ironiron/LCRmeter/LCRmeter_PCB/readme.md

# todo

- add connector for UART converter for debugging
- add testpoint for ADC measurments
- make oled from discrete parts, not module
- change connector for programmmer, and move it out of the top layer
- check if PCB can be smaller (especially batterry holder)
- add more Rseries options
- remove option without Rseries connected at all - it can fry PCB
- remove connection to 2nd ADCs
- Are there  better opamps??
- remove option for 1.5 V ref
