ironiron/LCRmeter/visualizer_data/r2k2ohm.png

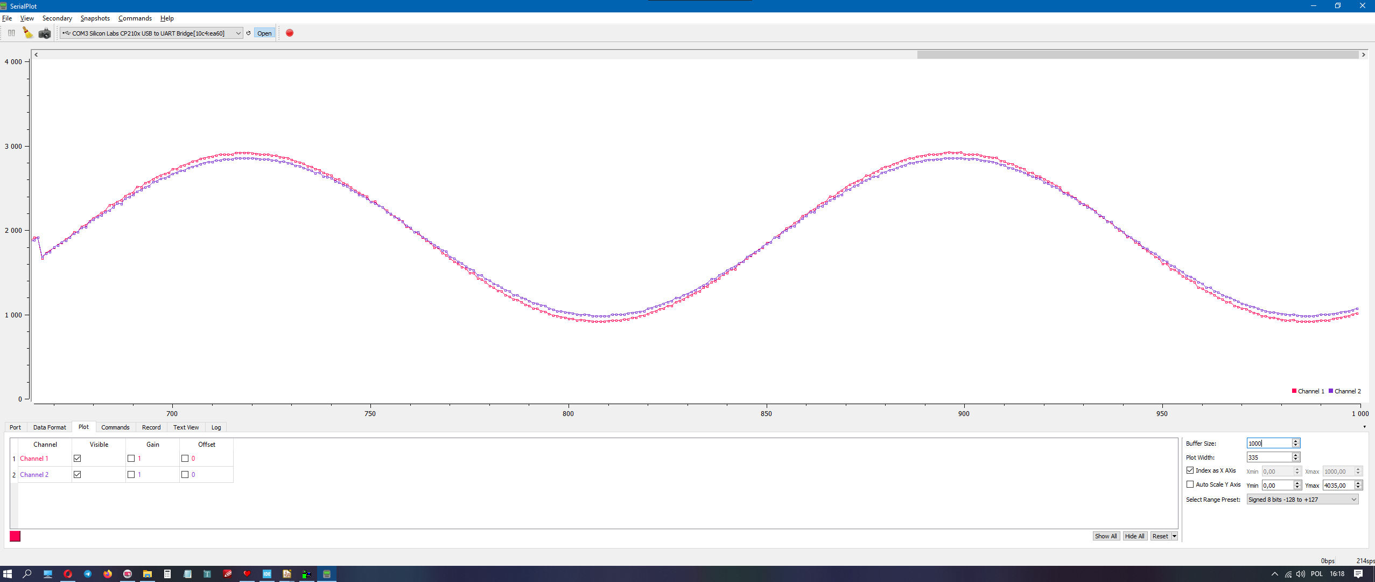
visualizer_data/r2k2ohm.png
