ironiron/LCRmeter/tests/readme.md

period of ADC data auqisition is 2.5us and is visivle on oscilloscope on waveform (photo quickprint 1)
qiuckprint 2 is merelry visible impact when coil is connected. quickprint 3 is fo electrolic capabilties
quickprint 4 is the fastest that I've managed on coil

# Power consumption
Module takes ca. 45 mA when DAC, adc is running
