ironiron/LCRmeter/tests/ADC sampling - 1.png

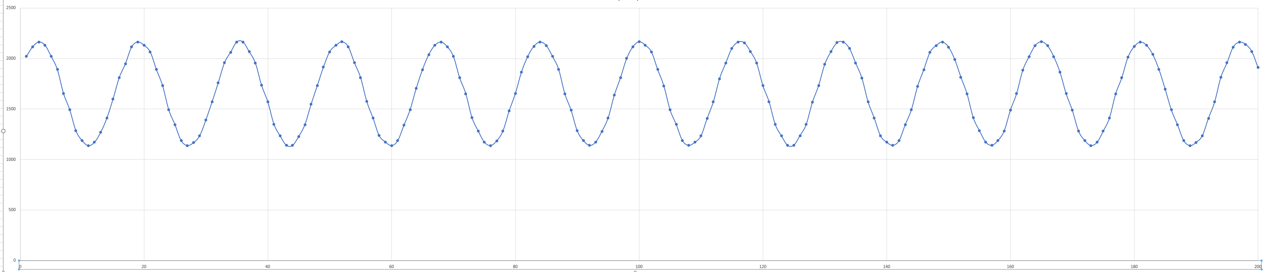
tests/ADC sampling - 1.png
