ironiron/LCRmeter/LCRmeter_PCB/lcrmeter.kicad_pcb

## KiCad design LCRmeter_PCB/lcrmeter.kicad_pcb (2024-01-05)

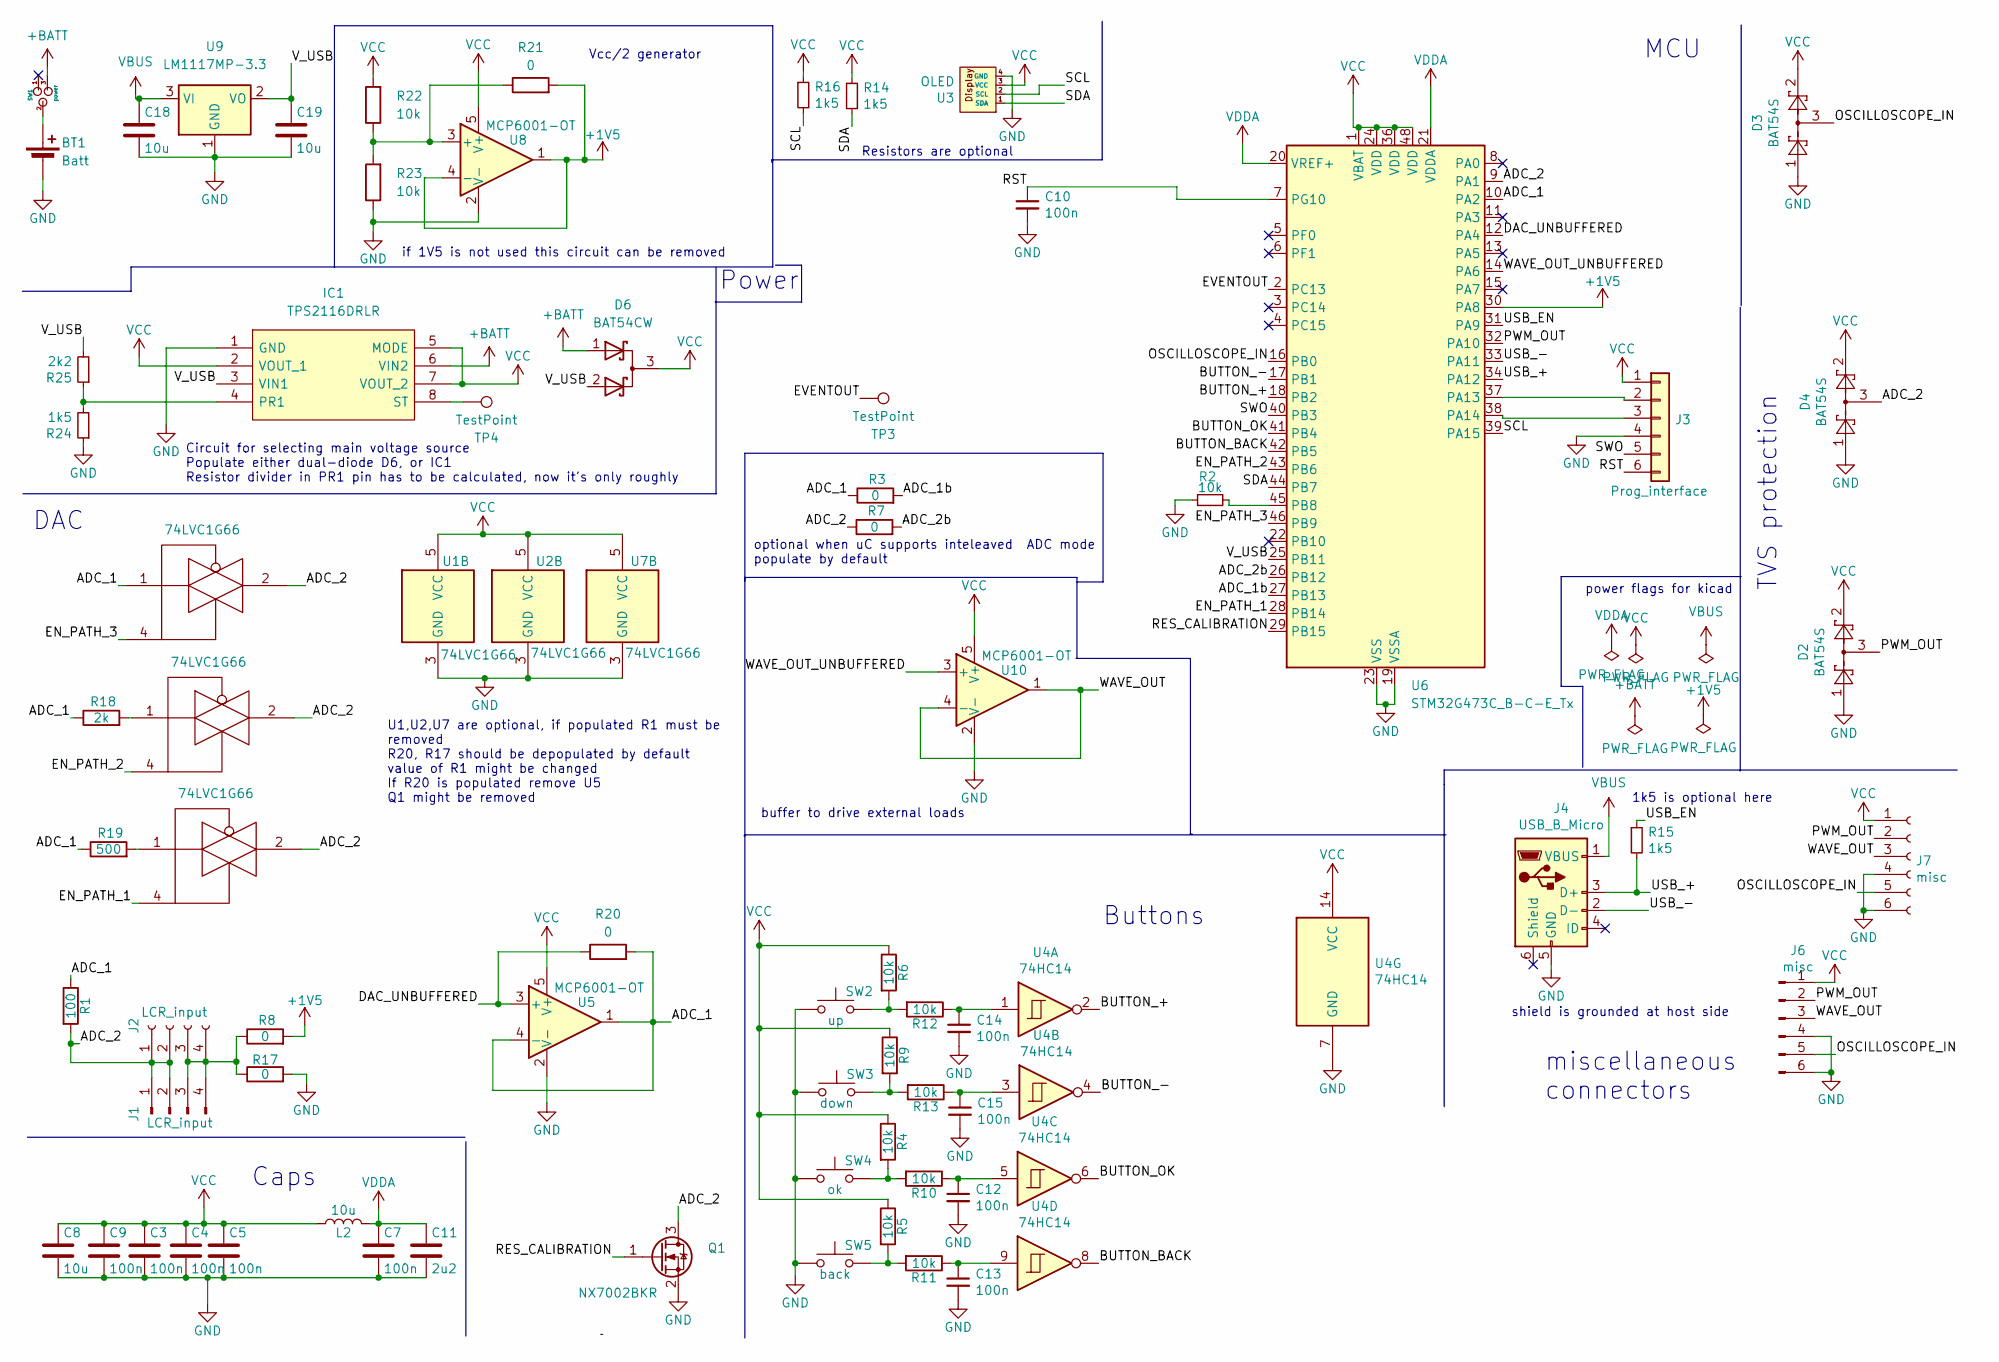
[picture p11: schematic lcrmeter.kicad_sch]

Parts:
BT1: Batt; BatteryHolder_Keystone_2468_2xAAA
C3, C4, C5, C7, C9, C10, C12, C13, C14, C15: 100n; C_0603_1608Metric_Pad1.08x0.95mm_HandSolder
C8, C18, C19: 10u; C_0805_2012Metric_Pad1.18x1.45mm_HandSolder
C11: 2u2; C_0603_1608Metric_Pad1.08x0.95mm_HandSolder
D2, D3, D4: BAT54S; SOT-23
D6: BAT54CW; SOT-23
IC1: TPS2116DRLR; SOTFL50P160X60-8N; Mouser Part Number 595-TPS2116DRLR
J1: LCR_input; PinHeader_1x04_P2.54mm_Vertical
J2: LCR_input; PinSocket_1x04_P2.54mm_Vertical
J3: Prog_interface; PinHeader_1x06_P2.54mm_Vertical
J4: USB_B_Micro; USB_Micro-B_Molex_47346-0001
J6: misc; PinSocket_1x06_P2.54mm_Vertical
J7: misc; PinHeader_1x06_P2.54mm_Vertical
L2: 10u; L_0805_2012Metric_Pad1.15x1.40mm_HandSolder
Q1: NX7002BKR; SOT-23
R1: 100; R_0805_2012Metric_Pad1.20x1.40mm_HandSolder
R2, R4, R5, R6, R9, R10, R11, R12, R13: 10k; R_0603_1608Metric_Pad0.98x0.95mm_HandSolder
R3, R7, R8, R17, R20, R21: 0; R_0805_2012Metric_Pad1.20x1.40mm_HandSolder
R14, R15, R16, R24: 1k5; R_0805_2012Metric_Pad1.20x1.40mm_HandSolder
R18: 2k; R_0805_2012Metric_Pad1.20x1.40mm_HandSolder
R19: 500; R_0805_2012Metric_Pad1.20x1.40mm_HandSolder
R22, R23: 10k; R_0805_2012Metric_Pad1.20x1.40mm_HandSolder
R25: 2k2; R_0805_2012Metric_Pad1.20x1.40mm_HandSolder
SW1: power; PinHeader_1x03_P2.54mm_Vertical
SW2: up; SW_SPST_REED_CT05-XXXX-G1
SW3: down; SW_SPST_REED_CT05-XXXX-G1
SW4: ok; SW_SPST_REED_CT05-XXXX-G1
SW5: back; SW_SPST_REED_CT05-XXXX-G1
TP3, TP4: TestPoint; TestPoint_Pad_1.0x1.0mm
U1, U2, U7: 74LVC1G66; SOT-23-5
U3: OLED; OLED_128x64
U4: 74HC14; SOIC-14_3.9x8.7mm_P1.27mm
U5, U8, U10: MCP6001-OT; SOT-23-5
U6: STM32G473C_B-C-E_Tx; LQFP-48_7x7mm_P0.5mm
U9: LM1117MP-3.3; SOT-223-3_TabPin2

Connections:
+1V5: R8.2, R21.2, U6.30 (PA8), U8.1, U8.4 (-)
+BATT: D6.1 (K), IC1.6 (VIN2), SW1.3
/ADC_1: R1.1, R3.1, R18.1, R19.1, R20.2, U5.1, U5.4 (-), U6.10 (PA2), U7.1
/ADC_1b: R3.2, U6.27 (PB13)
/ADC_2: D4.3, J1.1, J1.2, J2.1, J2.2, Q1.3 (D), R1.2, R7.1, U1.2, U2.2, U6.9 (PA1), U7.2
/ADC_2b: R7.2, U6.26 (PB12)
/BUTTON_+: U4.2, U6.18 (PB2)
/BUTTON_-: U4.4, U6.17 (PB1)
/BUTTON_BACK: U4.8, U6.42 (PB5)
/BUTTON_OK: U4.6, U6.41 (PB4)
/DAC_UNBUFFERED: R20.1, U5.3 (+), U6.12 (PA4)
/EN_PATH_1: U1.4, U6.28 (PB14)
/EN_PATH_2: U2.4, U6.43 (PB6)
/EN_PATH_3: U6.46 (PB9), U7.4
/EVENTOUT: TP3.1, U6.2 (PC13)
/OSCILLOSCOPE_IN: D3.3, J6.5, J7.5, U6.16 (PB0)
/PWM_OUT: D2.3, J6.2, J7.2, U6.32 (PA10)
/RES_CALIBRATION: Q1.1 (G), U6.29 (PB15)
/RST: C10.1, J3.6, U6.7 (PG10)
/SCL: R16.2, U3.2 (SCL), U6.39 (PA15)
/SDA: R14.2, U3.1 (SDA), U6.44 (PB7)
/SWO: J3.5, U6.40 (PB3)
/USB_+: J4.3 (D+), R15.2, U6.34 (PA12)
/USB_-: J4.2 (D-), U6.33 (PA11)
/USB_EN: R15.1, U6.31 (PA9)
/V_USB: C19.1, D6.2 (K), IC1.3 (VIN1), R25.2, U6.25 (PB11), U9.2 (VO)
/WAVE_OUT: J6.3, J7.3, U10.1, U10.4 (-)
/WAVE_OUT_UNBUFFERED: U6.14 (PA6), U10.3 (+)
GND: BT1.2 (-), C3.2, C4.2, C5.2, C7.2, C8.2, C9.2, C10.2, C11.2, C12.2, C13.2, C14.2, C15.2, C18.2, C19.2, D2.1, D3.1, D4.1, IC1.1 (GND), J3.4, J4.5 (GND), J6.4, J6.6, J7.4, J7.6, Q1.2 (S), R2.1, R17.2, R23.1, R24.1, SW2.1, SW3.1, SW4.1, SW5.1, U1.3 (GND), U2.3 (GND), U3.4 (GND), U4.7 (GND), U5.2 (V-), U6.19 (VSSA), U6.23 (VSS), U6.35 (VSS), U6.47 (VSS), U7.3 (GND), U8.2 (V-), U9.1 (GND), U10.2 (V-)
unnamed: BT1.1 (+), SW1.2
unnamed: C12.1, R10.1, U4.5
unnamed: C13.1, R11.1, U4.9
unnamed: C14.1, R12.1, U4.1
unnamed: C15.1, R13.1, U4.3
unnamed: IC1.4 (PR1), R24.2, R25.1
unnamed: IC1.8 (ST), TP4.1
unnamed: J1.3, J1.4, J2.3, J2.4, R8.1, R17.1
unnamed: J3.2, U6.37 (PA13)
unnamed: J3.3, U6.38 (PA14)
unnamed: R4.2, R10.2, SW4.2
unnamed: R5.2, R11.2, SW5.2
unnamed: R6.2, R12.2, SW2.2
unnamed: R9.2, R13.2, SW3.2
unnamed: R18.2, U2.1
unnamed: R19.2, U1.1
unnamed: R2.2, U6.45 (PB8)
unnamed: R21.1, R22.1, R23.2, U8.3 (+)
VBUS: C18.1, J4.1 (VBUS), U9.3 (VI)
VCC: C3.1, C4.1, C5.1, C8.1, C9.1, D2.2, D3.2, D4.2, D6.3 (A), IC1.2 (VOUT_1), IC1.5 (MODE), IC1.7 (VOUT_2), J3.1, J6.1, J7.1, L2.1, R4.1, R5.1, R6.1, R9.1, R14.1, R16.1, R22.2, U1.5 (VCC), U2.5 (VCC), U3.3 (VCC), U4.14 (VCC), U5.5 (V+), U6.1 (VBAT), U6.24 (VDD), U6.36 (VDD), U6.48 (VDD), U7.5 (VCC), U8.5 (V+), U10.5 (V+)
VDDA: C7.1, C11.1, L2.2, U6.20 (VREF+), U6.21 (VDDA)

Notes on the sheet:
if 1V5 is not used this circuit can be removed
Vcc/2 generator
Power
shield is grounded at host side
buffer to drive external loads
Circuit for selecting main voltage source Populate either dual-diode D6, or IC1 Resistor divider in PR1 pin has to be calculated, now it's only roughly
Buttons
U1,U2,U7 are optional, if populated R1 must be removed R20, R17 should be depopulated by default value of R1 might be changed If R20 is populated remove U5 Q1 might be removed
TVS protection
miscellaneous connectors
1k5 is optional here
optional when uC supports inteleaved ADC mode populate by default
Resistors are optional
power flags for kicad
Caps
DAC
MCU

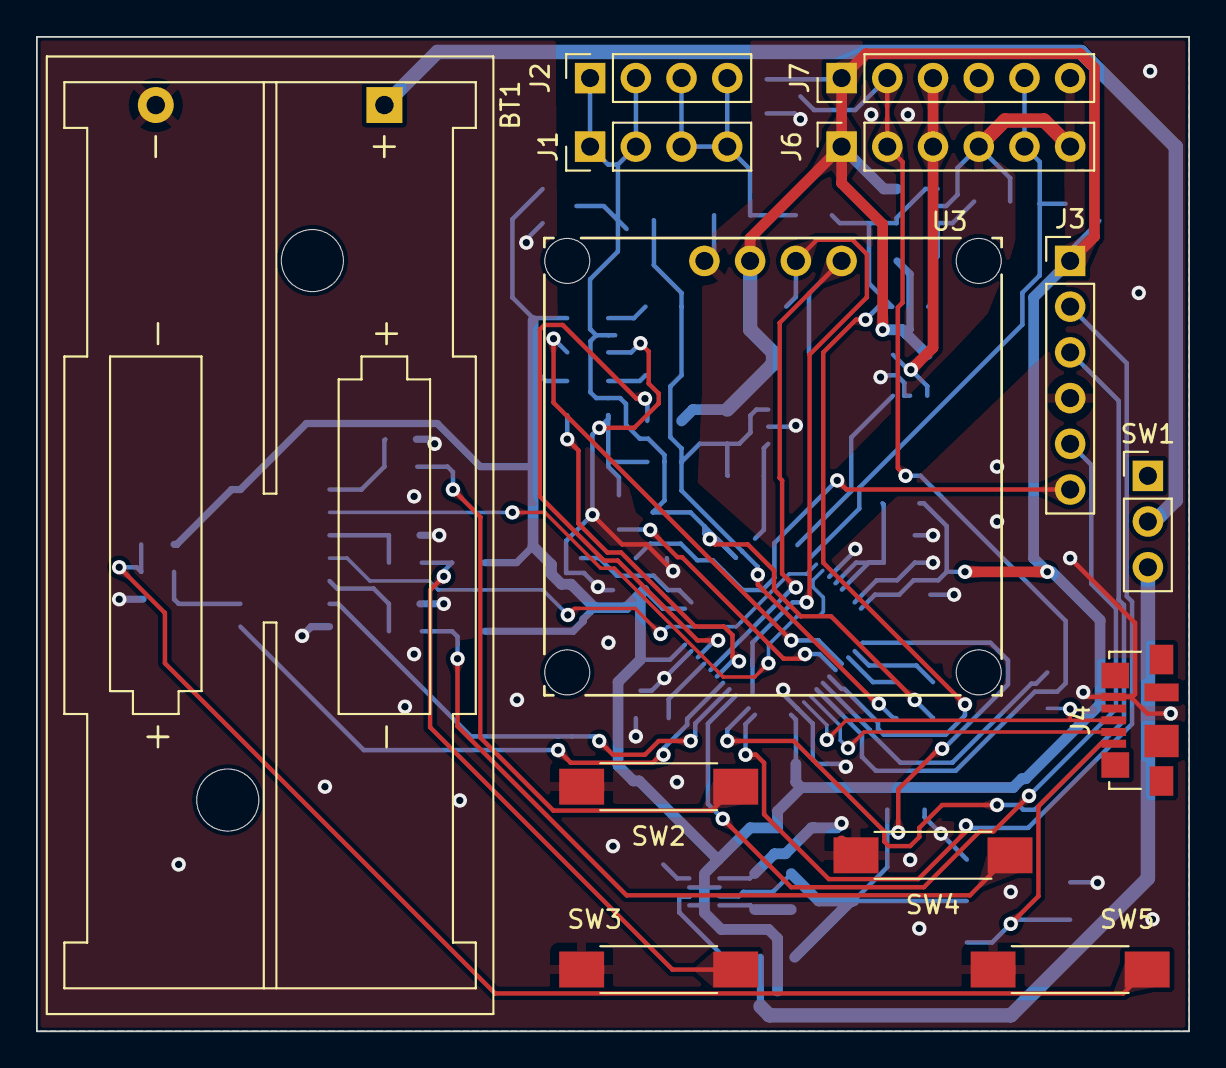
[picture p12: board lcrmeter.kicad_pcb from above]

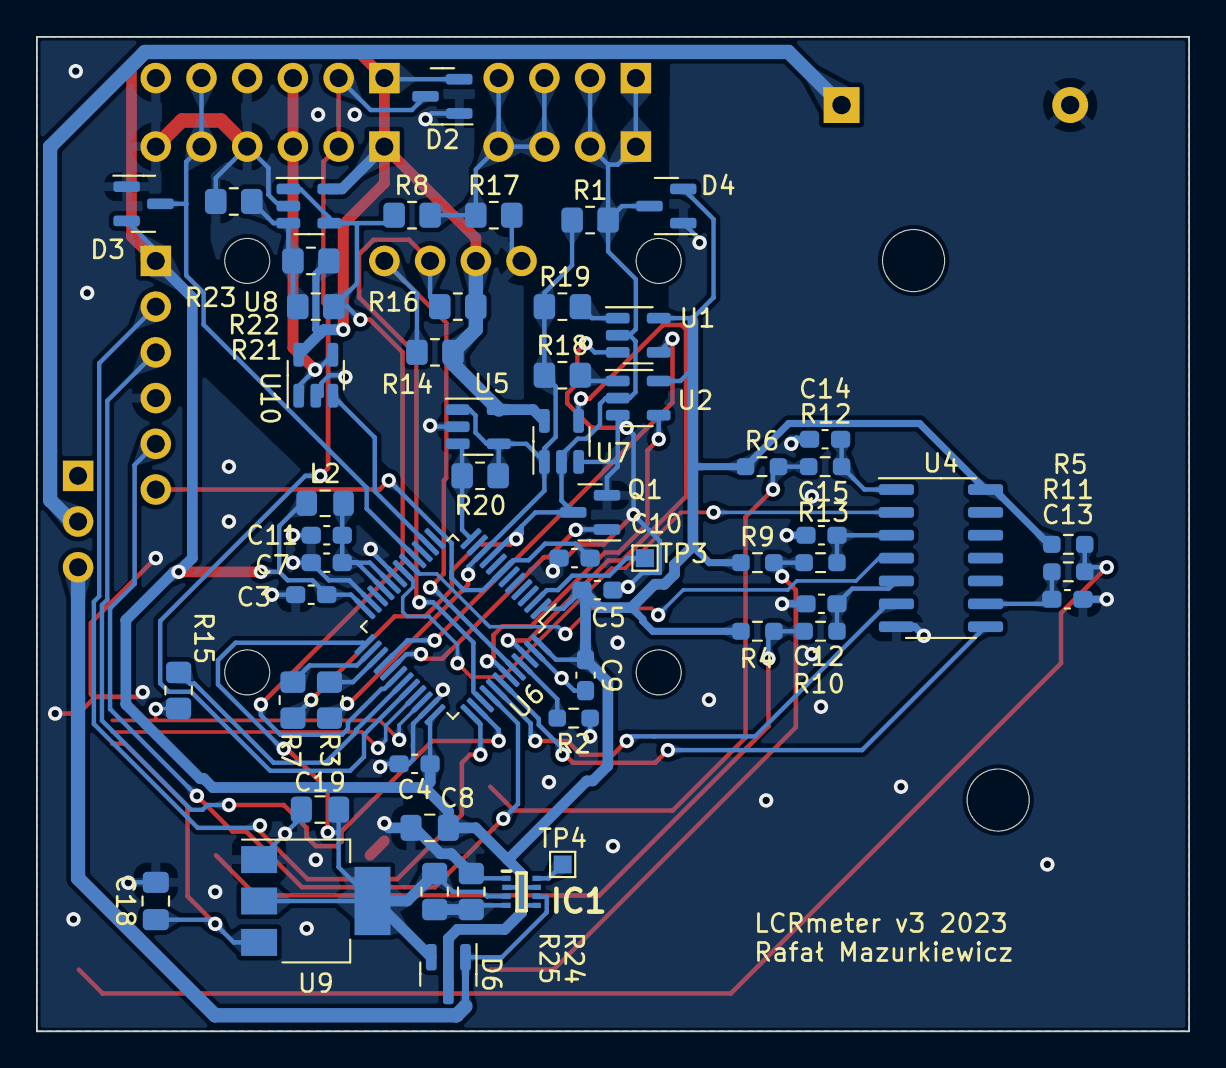
[picture p13: board lcrmeter.kicad_pcb from below]

Board: 2 copper layers, 64.0 x 55.2 mm, 70 parts (57 on the bottom side), 50 nets.
