ironiron/LCRmeter/LCRmeter_CODE/Core/Src/main.cpp

/* USER CODE BEGIN Header */
/**
 ******************************************************************************
 * @file           : main.cpp
 * @brief          : Main program body
 ******************************************************************************
* @attention
  *
  * Copyright (c) 2023 STMicroelectronics.
  * All rights reserved.
  *
  * This software is licensed under terms that can be found in the LICENSE file
  * in the root directory of this software component.
  * If no LICENSE file comes with this software, it is provided AS-IS.
  *
  ******************************************************************************
 */

/**@mainpage This project contains source code for simple and cheap LCRmeter
 * It is capable of measuring resistance, inductance, capacitance.
 * For more hardware related stuff go to
 * LCRmeter_PCB directory outside this folder.
 * \ref md_LICENSE.md
 */

#include <stdio.h>
#include <string>
#include <vector>

#include "main.h"
#include "usb_device.h"
#include "Pwm.hpp"
#include "delay.h"
#include "Waveformarythmetics.hpp"
#include "SSD1306.hpp"
#include "adc.hpp"
#include "LCRmath.hpp"
#include "sine.hpp"
#include "MovingAverager.hpp"
#include "Maintask.h"


ADC_HandleTypeDef hadc1;
ADC_HandleTypeDef hadc2;
ADC_HandleTypeDef hadc3;
ADC_HandleTypeDef hadc4;
ADC_HandleTypeDef hadc5;
DMA_HandleTypeDef hdma_adc1;
DMA_HandleTypeDef hdma_adc3;
DMA_HandleTypeDef hdma_adc5;

CORDIC_HandleTypeDef hcordic;

DAC_HandleTypeDef hdac1;
DAC_HandleTypeDef hdac2;
DMA_HandleTypeDef hdma_dac1_ch1;

I2C_HandleTypeDef hi2c1;

TIM_HandleTypeDef htim1;
TIM_HandleTypeDef htim2;
TIM_HandleTypeDef htim6;

extern "C"
{
#include "printf_redirection.h"

void SystemClock_Config(void);
static void MX_GPIO_Init(void);
static void MX_DMA_Init(void);
static void MX_DAC1_Init(void);
static void MX_DAC2_Init(void);
static void MX_ADC1_Init(void);
static void MX_ADC2_Init(void);
static void MX_ADC3_Init(void);
static void MX_ADC4_Init(void);
static void MX_ADC5_Init(void);
static void MX_CORDIC_Init(void);
static void MX_I2C1_Init(void);
static void MX_TIM1_Init(void);
static void MX_TIM2_Init(void);
static void MX_TIM6_Init(void);


ADC_HandleTypeDef adc;


volatile unsigned int a1=0;
volatile unsigned int a2=0;
void HAL_ADC_ErrorCallback(ADC_HandleTypeDef *hadc)
{
    if(hadc->Instance == ADC1)
    {
        a1++;
    }
    if(hadc->Instance == ADC2)
    {
        a2++;
    }
//    printf("---%d\n",hadc->ErrorCode);
//    ADC_CLEAR_ERRORCODE(hadc);
//    CLEAR_BIT(hadc->ErrorCode, (HAL_ADC_ERROR_OVR | HAL_ADC_ERROR_DMA));
}

static void Init(void)
{
    HAL_Init();
    SystemClock_Config();
    MX_GPIO_Init();
    MX_DMA_Init();
    MX_DAC1_Init();
    MX_DAC2_Init();
    MX_ADC1_Init();
    MX_ADC2_Init();
    MX_ADC3_Init();
    MX_ADC4_Init();
    MX_ADC5_Init();
    MX_CORDIC_Init();
//	  MX_USB_Device_Init();
    MX_I2C1_Init();
    MX_TIM1_Init();
    MX_TIM2_Init();
    MX_TIM6_Init();
}


int main(void)
{
    Init();
    HAL_Delay(100);

    Waveform_arythmetics::hysteresis_samples = 10;
    Waveform_arythmetics::user_point_time = static_cast<float>(0.3529411);

    UART_printf_init();
    printf("hola!! \n");

    Loop();
    //should never exit
}

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
