ironiron/LCRmeter/LCRmeter_CODE/generator/Core/Inc/main.h

#define ADC_2_Pin GPIO_PIN_1
#define ADC_2_GPIO_Port GPIOA
#define ADC_1_Pin GPIO_PIN_2
#define ADC_1_GPIO_Port GPIOA
#define OSCILLOSCOPE_IN_Pin GPIO_PIN_0
#define OSCILLOSCOPE_IN_GPIO_Port GPIOB
#define BUTTON_DOWN_Pin GPIO_PIN_1
#define BUTTON_DOWN_GPIO_Port GPIOB
#define BUTTON_DOWN_EXTI_IRQn EXTI1_IRQn
#define BUTTON_UP_Pin GPIO_PIN_2
#define BUTTON_UP_GPIO_Port GPIOB
#define BUTTON_UP_EXTI_IRQn EXTI2_IRQn
#define V_USB_IN_Pin GPIO_PIN_11
#define V_USB_IN_GPIO_Port GPIOB
#define V_USB_IN_EXTI_IRQn EXTI15_10_IRQn
#define ADC_1b_Pin GPIO_PIN_13
#define ADC_1b_GPIO_Port GPIOB
#define EN_PATH_1_Pin GPIO_PIN_14
#define EN_PATH_1_GPIO_Port GPIOB
#define RES_CALIBRATION_Pin GPIO_PIN_15
#define RES_CALIBRATION_GPIO_Port GPIOB
#define BUTTON_OK_Pin GPIO_PIN_4
#define BUTTON_OK_GPIO_Port GPIOB
#define BUTTON_OK_EXTI_IRQn EXTI4_IRQn
#define BUTTON_BACK_Pin GPIO_PIN_5
#define BUTTON_BACK_GPIO_Port GPIOB
#define BUTTON_BACK_EXTI_IRQn EXTI9_5_IRQn
#define EN_PATH_2_Pin GPIO_PIN_6
#define EN_PATH_2_GPIO_Port GPIOB
#define EN_PATH_3_Pin GPIO_PIN_9
#define EN_PATH_3_GPIO_Port GPIOB
#define BUTTON_OK_Pin GPIO_PIN_2
#define BUTTON_OK_GPIO_Port GPIOA
#define BUTTON_OK_EXTI_IRQn EXTI2_IRQn
#define BUTTON_BACK_Pin GPIO_PIN_3
#define BUTTON_BACK_GPIO_Port GPIOA
#define BUTTON_BACK_EXTI_IRQn EXTI3_IRQn
#define BUTTON_OKA4_Pin GPIO_PIN_4
#define BUTTON_OKA4_GPIO_Port GPIOA
#define BUTTON_OKA4_EXTI_IRQn EXTI4_IRQn
#define BUTTON_UP_Pin GPIO_PIN_5
#define BUTTON_UP_GPIO_Port GPIOA
#define BUTTON_UP_EXTI_IRQn EXTI9_5_IRQn
