ironiron/LCRmeter/LCRmeter_CODE/Core/Src/Maintask.cpp

/*
 * Maintask.cpp
 *
 *  Created on: Jun 21, 2025
 *      Author: xDDD
 */

#include <stdio.h>
#include <string>
#include <vector>
#include "Maintask.h"
#include "LLutils.h"
#include "usb_device.h"
#include "Pwm.hpp"
#include "delay.h"
#include "Waveformarythmetics.hpp"
#include "SSD1306.hpp"
#include "adc.hpp"
#include "LCRmath.hpp"
#include "sine.hpp"
#include "MovingAverager.hpp"
#include "Maintask.h"
#include "common_defines.hpp"
#include "Menu01.hpp"

//TODO make those XY coordinates on GUI a little bit more concise, maybe make some #define?

/**
 * @brief in this file most of the logic for starting and displaying measurments is present
 *
 * Functions here are rouhly consisting of 3 groups - initialization,
 * processing, and displaying. There's also \ref LOG macro for crude debugging during development.
 * @note that any ADC error is not handled, instead a reset is expected.
 *
 * Logic is handled via GUI callbacks and enums
 *
 * ADC
 */

extern ADC_HandleTypeDef hadc1;
extern ADC_HandleTypeDef hadc2;
extern ADC_HandleTypeDef hadc3;
extern ADC_HandleTypeDef hadc5;
extern I2C_HandleTypeDef hi2c1; // for oled display


volatile unsigned int button_up=0;
volatile unsigned int button_down=0;
volatile unsigned int button_ok=0;
volatile unsigned int button_back=0;

constexpr unsigned int max_average = 20;
MovingAverager<uint32_t, max_average, false> vref_avg;
MovingAverager<decltype(LCR_math::capacitance), max_average, true> cap;
MovingAverager<decltype(LCR_math::inductance), max_average, true> in;
MovingAverager<decltype(LCR_math::resistance), max_average, true> res;
MovingAverager<decltype(LCR_math::loss_angle), max_average, true> los;
MovingAverager<decltype(Waveform_arythmetics::alfa), max_average, true> ang;

 enum {
    LCR,
    OSCILLOSCOPE,
    V_TEMP,

} state = LCR;

enum {
   NONE,
   FREQ,
   R_SER,
   PERIOD,
   EDGE

} settings_state = NONE;

SSD1306 oled(&hi2c1, 64);

static       char buf[30];

auto menu_main=Menu01_base::menu_list("",{"LCR","OSC","BAT","PWM"});
auto menu_lcr=Menu01_base::menu_list("LCR",{"freq","R_ser"},&menu_main,0);
auto menu_osc=Menu01_base::menu_list("Oscilloscope",{"Sample period","edge level"},&menu_main,1);
auto menu_pwm=Menu01_base::menu_list("PWM",{"DUTY","FREQUENCY"},&menu_main,3);
//
auto menu_lcr_freq=Menu01_base::menu_list("",{""},&menu_lcr,0);
auto menu_lcr_r_ser=Menu01_base::menu_list("",{""},&menu_lcr,1);

auto menu_osc_period=Menu01_base::menu_list("",{""},&menu_osc,0);
auto menu_osc_edge=Menu01_base::menu_list("",{""},&menu_osc,1);

static  LCR_math::load_type_t load_type = LCR_math::load_type_t::ERROR;

Menu01 menu=Menu01(&menu_main);

void error_informer(int error,int line)
{
    oled.Set_Font_size(Fonts::font_16x26);
    oled.Set_Cursor(0, 0);
    oled.Write_String("Error:");
    oled.Set_Cursor(0, 30);
    snprintf(buf,20,"%d_%d",line,error);
    oled.Write_String(buf);
    oled.Update_Screen();
    HAL_Delay(3000);

    //now do a reset, we don't have recoverable solution for now
    NVIC_SystemReset();
}

#define OLED_WAVEFORM_X 27
#define OLED_WAVEFORM_Y 13
#define OLED_LCR_X 30

#define LOG(x) error_informer(static_cast<int>((x)),__LINE__);

/*
 * @brief Handles cleaning after ADC mode has been changed
 */
void DeInit(void)
{
    HAL_ADC_Stop_DMA(&hadc5);
    HAL_ADC_Stop_DMA(&hadc3);
    HAL_ADCEx_MultiModeStop_DMA(&hadc1);
    HAL_ADC_Stop(&hadc2);
    HAL_Delay(20); //let's put some artificial delay to finish any ongoing transaction
    //overwrite any lingering error in HAL state machine
    hadc1.State = HAL_ADC_STATE_READY;
    hadc2.State = HAL_ADC_STATE_READY;
    hadc3.State = HAL_ADC_STATE_READY;
    hadc5.State = HAL_ADC_STATE_READY;
}

/*
 * @brief for debugging
 */
void print_result(void)
{
    printf("a1=%ld\n", Waveform_arythmetics::amplitude1);
    printf("a2=%ld\n", Waveform_arythmetics::amplitude2);
    printf("f=%ld\n", Waveform_arythmetics::frequency);
    printf("a=%f\n", Waveform_arythmetics::alfa);
    printf("a1=%ld volts\n",
            Adc::Adc_To_Milivolts(Waveform_arythmetics::amplitude1));
    printf("a2=%ld volts\n",
            Adc::Adc_To_Milivolts(Waveform_arythmetics::amplitude2));

    printf("nbr_of_minimas[0]=%ld\n", Waveform_arythmetics::nbr_of_minimas[0]);
    printf("nbr_of_peaks[0]=%ld\n", Waveform_arythmetics::nbr_of_peaks[0]);
    printf("nbr_of_minimas[1]=%ld\n", Waveform_arythmetics::nbr_of_minimas[1]);
    printf("nbr_of_peaks[1]=%ld\n", Waveform_arythmetics::nbr_of_peaks[1]);
    printf("nbr_of_peaks[1]=%ld\n", Waveform_arythmetics::nbr_of_peaks[1]);
    printf("peaks[0][0]=%ld\n", Waveform_arythmetics::peaks[0][0]);
    printf("peaks[0][1]=%ld\n", Waveform_arythmetics::peaks[0][1]);
    printf("peaks[1][0]=%ld\n", Waveform_arythmetics::peaks[1][0]);
    printf("peaks[1][1]=%ld\n", Waveform_arythmetics::peaks[1][1]);
    printf("peaks[0][2]=%ld\n", Waveform_arythmetics::peaks[0][2]);
    printf("peaks[1][2]=%ld\n", Waveform_arythmetics::peaks[1][2]);

    printf("minimas=%ld\n", Waveform_arythmetics::minimas[0][0]);

    printf("cap=%1.9f F\n", LCR_math::capacitance);
    printf("ind=%1.9f H\n", LCR_math::inductance);
    printf("res=%1.9f R\n", LCR_math::resistance);
    printf("loss angle=%1.9f degs\n", LCR_math::loss_angle);
    for (unsigned int i = 0; i < Waveform_arythmetics::buffer_size; i++)
    {

        printf("%d, %d\n", Waveform_arythmetics::filtered_buffer[0][i],
                Waveform_arythmetics::filtered_buffer[1][i]);
        if (Waveform_arythmetics::filtered_buffer[0][i] == 0)
        {
            printf("i= %d (from back = %ld\n", i, Adc::size_of_adc_buffer - i);
            break;
        }
    }
    printf("hadc1---%ld\n", hadc1.ErrorCode);
    printf("hadc2---%ld\n", hadc2.ErrorCode);
    HAL_Delay(2000);
}

void Init_Oscilloscope([[maybe_unused]] unsigned int i)
{
    DeInit();
    state = OSCILLOSCOPE;
    settings_state = NONE;

//        Adc::Set_Sampling_time(Adc::SamplingTimeClocks::ADCCLK_247CYCLES5);
    if (Adc::Start_Oscilloscope())
    {
        LOG(1);
    }
}

void Print_Oscilloscope(void)
{
    uint8_t display_buffer[100];

    Waveform_arythmetics::Calc_Moving_Average(Adc::adc_buffer,
            Adc::size_of_adc_buffer, 1);
    // todo implement edge detection (in percent maybe??)
    uint32_t edge = Waveform_arythmetics::Get_Edge_index(1000, false);

    edge = 0;

    // normalize voltage value for displaying in 100x50 window
    for (int i = 0; i < 100; i++)
    {
        display_buffer[i] = Waveform_arythmetics::filtered_buffer[0][i + edge]
                / 82;
    }
    oled.Draw_Waveform(OLED_WAVEFORM_X, 63, display_buffer, 100,
            SSD1306::WHITE);
}


void adjust_osc_period_settings_clb([[maybe_unused]] unsigned int index)
{
        settings_state = PERIOD;
}

void adjust_osc_edge_settings_clb([[maybe_unused]] unsigned int index)
{
        settings_state = EDGE;
}

/*
 * @brief Initializes LCR measurment with previously used settings
 * see \ref HAL_ADC_ConvCpltCallback for how the results are evaluated
 * @param i unused
 */
void Init_LCR_Measurment([[maybe_unused]] unsigned int i)
{
       DeInit();
       Set_DAC_Frequency(Get_DAC_Frequency());
       Set_Rseries(Get_Rseries());
       state = LCR;
       settings_state = NONE;

       auto retval = HAL_ADC_Start(&hadc2);
       if (retval != 0)
       {
           LOG(retval)
       }
       if (Adc::Start_LCR())
       {
           LOG(1);
       }
}

void Do_LCR_Calculations(void)
{
    Waveform_arythmetics::Calc_Moving_Average( Adc::adc_buffer,
            Adc::size_of_adc_buffer, 1);

    Waveform_arythmetics::Find_Peaks();
    Waveform_arythmetics::Calc_Frequency();
    Waveform_arythmetics::Calc_Alfa();
    Waveform_arythmetics::Calc_Amplitude();


    if (Waveform_arythmetics::nbr_of_peaks[1] < 2
            || Waveform_arythmetics::nbr_of_peaks[0] < 2)
    {
        printf("WARNING!!!!!!! number of peaks too small!!\n");
        load_type = LCR_math::load_type_t::ERROR;
        return;
    }
    else
    {
        load_type= LCR_math::Calculate(
                Adc::Adc_To_Milivolts(Waveform_arythmetics::amplitude1),
                Adc::Adc_To_Milivolts(Waveform_arythmetics::amplitude2),
                double(Waveform_arythmetics::alfa),
                Waveform_arythmetics::frequency);

        if(load_type == LCR_math::load_type_t::ERROR)
        {
            return;
        }
        if(load_type == LCR_math::load_type_t::CAPACITIVE)
        {
            cap.insert(LCR_math::capacitance);
        }
        if(load_type == LCR_math::load_type_t::INDUCTIVE)
        {
            in.insert(LCR_math::inductance);
        }
        if(LCR_math::resistance>0)
        {
            res.insert(LCR_math::resistance);
        }



        los.insert(LCR_math::loss_angle);
        ang.insert(Waveform_arythmetics::alfa);
    }
}

void Print_LCR(void)
{
    //        print_result();
    if (load_type == LCR_math::load_type_t::ERROR)
    {
        sprintf(buf, "open load");
        oled.Set_Cursor(35, 25);
        oled.Write_String(buf);
        return;
    }
    if (load_type == LCR_math::load_type_t::CAPACITIVE)
    {
        sprintf(buf, "%.9f F", cap.average());
        oled.Set_Cursor(OLED_LCR_X, 25);
        oled.Write_String(buf);
    }
    if (load_type == LCR_math::load_type_t::INDUCTIVE)
    {
        sprintf(buf, "%.9f H", in.average());
        oled.Set_Cursor(OLED_LCR_X, 25);
        oled.Write_String(buf);
    }
    sprintf(buf, "R=%3.2f R", res.average());
    oled.Set_Cursor(OLED_LCR_X, 35);
    oled.Write_String(buf);

    sprintf(buf, "phi = %2.3f", los.average());
    oled.Set_Cursor(OLED_LCR_X, 45);
    oled.Write_String(buf);

    sprintf(buf, "%lu Hz; %lu Ohm", Get_DAC_Frequency(), Get_Rseries());
    oled.Set_Cursor(OLED_LCR_X, 55);
    oled.Write_String(buf);

}

void adjust_LCR_rser_settings_clb([[maybe_unused]] unsigned int index)
{
        settings_state = R_SER;
}

void adjust_LCR_freq_settings_clb([[maybe_unused]] unsigned int index)
{
        settings_state = FREQ;
}


/*
 * @brief Starts Vbat and temperature measurment
 *  see \ref HAL_ADC_ConvCpltCallback for how the results are evaluated
 * @param i unused
 */
void Init_V_Temp([[maybe_unused]] unsigned int i)
{
    DeInit();
    vref_avg.reset();
    state = V_TEMP;

    auto ret = HAL_ADC_Start_DMA(&hadc5, Adc::volt_temp, 2);
    if (ret != 0)
    {
        LOG(ret)
    }
}

/*
 * @brief Callback invoked when ADC completed
 * @param hadc based on this will evaluate results
 */
void HAL_ADC_ConvCpltCallback(ADC_HandleTypeDef *hadc)
{
//    printf("dd\n");
    if(hadc == &hadc1) // LCR
    {
        Do_LCR_Calculations();
        if (Adc::Start_LCR())
        {
            LOG(1);
        }
    }
    if(hadc == &hadc3) // OSCilloscope
    {
        if (Adc::Start_Oscilloscope())
        {
            LOG(1);
        }
    }
    if(hadc == &hadc5) // VBAT
    {
        vref_avg.insert(Adc::Get_Vref());
        //if averager is filled let;s update the batterry voltage
        if(vref_avg.get(0) != 0)
        {
            Adc::Update_Vref(vref_avg.average());
        }

       auto  ret = HAL_ADC_Start_DMA(&hadc5, Adc::volt_temp, 2);
        if (ret != 0)
        {
            LOG(ret)
        }
    }
}

void Handle_GUI(void)
{
    //FIXME take into account parent's size, this if menu.HasParent shall be in external for loop!
    oled.Fill(SSD1306::BLACK);
    for (uint8_t i = 0; i < menu.GetMenuLength(); ++i)
    {
        oled.Set_Cursor(0, (uint8_t) i * 10 + 3);
        if (menu.HasParent())
        {
            oled.Write_String(menu.GetParent()->Get_item(i).data());
        }
        else
        {
            oled.Write_String(menu.GetListItem(i).data());
        }
    }
    if (menu.HasParent())
    {
        auto parent_index = menu.GetParent()->Get_parent_index();
        oled.Set_Cursor(0, (uint8_t) parent_index * 10 + 3);
        oled.Write_String_Inverted(
                menu.GetParent()->Get_item(parent_index).data());

        for (uint8_t i = 0; i < menu.GetMenuLength(); ++i)
        {
            oled.Set_Cursor(35, (uint8_t) i * 10 + 3);
            oled.Write_String(menu.GetListItem(i).data());
        }
        oled.Set_Cursor(35, (uint8_t) menu.CurrentItemInd() * 10 + 3);
        oled.Write_String_Inverted(menu.CurrentItemStr().data());
    }
    else
    {
        oled.Set_Cursor(0, (uint8_t) menu.CurrentItemInd() * 10 + 3);
        oled.Write_String_Inverted(menu.CurrentItemStr().data());
    }

    switch (state)
    {
        case LCR:
            Print_LCR();
            break;
        case OSCILLOSCOPE:
            Print_Oscilloscope();
            break;
        case V_TEMP:
            sprintf(buf, "%04lu mV", vref_avg.average());
            oled.Set_Cursor(40, 20);
            oled.Write_String(buf);
            sprintf(buf, "%d deg. C", Adc::Get_Temperature());
            oled.Set_Cursor(40, 40);
            oled.Write_String(buf);
            break;

        default:
            break;
    }

    if (settings_state == FREQ)
    {
        oled.Set_Cursor(35, 3);
        sprintf(buf, "%d", Get_DAC_Frequency());
        oled.Write_String_Inverted(buf);
    }
    if (settings_state == R_SER)
    {
        oled.Set_Cursor(35, 13);
        sprintf(buf, "%d", Get_Rseries());
        oled.Write_String_Inverted(buf);
    }

    if (settings_state == PERIOD)
    {
        oled.Set_Cursor(35, 3);
        sprintf(buf, "%1.2f us", Get_period());
        oled.Write_String_Inverted(buf);
    }
    if (settings_state == EDGE)
    {
        oled.Set_Cursor(35, 13);
        sprintf(buf, "%u%%", Get_Edge_Level());
        oled.Write_String_Inverted(buf);
    }
    oled.Update_Screen();
}

void Loop(void)
{
   //Update VBAT as the first step!
    Init_V_Temp(0);

    //First create menu's callbacks
   menu_main.Register_callback(0, Init_LCR_Measurment);
   menu_main.Register_callback(1, Init_Oscilloscope);
   menu_main.Register_callback(2, Init_V_Temp);
   //settings
   menu_lcr_freq.Register_callback(0, adjust_LCR_freq_settings_clb);
   menu_lcr_r_ser.Register_callback(0, adjust_LCR_rser_settings_clb);

   menu_osc_period.Register_callback(0, adjust_osc_period_settings_clb);
   menu_osc_edge.Register_callback(0, adjust_osc_edge_settings_clb);


   oled.Initialize();
   oled.Set_Brightness(0xff);
   oled.Fill(SSD1306::WHITE);
   oled.Update_Screen();

   delay_ms(500); // give some time for battery voltage update
   oled.Fill(SSD1306::BLACK);
   oled.Update_Screen();

   printf("Vbat is %ld\n",Adc::vref);

   //after this point VBAT should be ready so let's start normal operation
   Init_LCR_Measurment(0);

   while(1)
   {
       //let's check if buttons are pressed
       if(settings_state == NONE)
       {
           if(button_up)
           {
               button_up =0;
               menu.MoveUp();
           }
           if(button_down)
           {
               button_down = 0;
               menu.MoveDown();
           }
           if(button_ok)
           {
               button_ok = 0;
               menu.GoIn();
           }
           if(button_back)
           {
               button_back=0;
               menu.GoOut();
           }
       }
       else if(settings_state == FREQ)
       {
           if(button_up)
           {
               button_up =0;
               Increase_DAC_frequncy();
           }
           if(button_down)
           {
               button_down = 0;
               Decrease_DAC_frequncy();

           }
           if(button_back)
           {
               button_back=0;
               settings_state = NONE;
               menu.GoOut();
           }

       }
       else if(settings_state == R_SER)
       {
           if(button_up)
           {
               button_up =0;
               Increase_Rseries();
           }
           if(button_down)
           {
               button_down = 0;
               Decrease_Rseries();

           }
           if(button_back)
           {
               button_back=0;
               settings_state = NONE;
               menu.GoOut();
           }

       }
       else if(settings_state == PERIOD)
       {
           if(button_up)
           {
               button_up =0;
               Increase_period();
           }
           if(button_down)
           {
               button_down = 0;
               Decrease_period();

           }
           if(button_back)
           {
               button_back=0;
               settings_state = NONE;
               menu.GoOut();
           }
       }
       else if(settings_state == EDGE)
       {
           if(button_up)
           {
               button_up =0;
               Increase_Edge_Level();
           }
           if(button_down)
           {
               button_down = 0;
               Decrease_Edge_Level();

           }
           if(button_back)
           {
               button_back=0;
               settings_state = NONE;
               menu.GoOut();
           }
       }
    Handle_GUI();
   }
}
