ironiron/LCRmeter/LCRmeter_CODE/Core/Inc/sine.hpp

/*
 * sine.hpp
 *
 *  Created on: Jan 19, 2025
 *      Author: Rafał
 */

#ifndef INC_SINE_HPP_
#define INC_SINE_HPP_

#include <array>
#include <stdint.h>

static inline constexpr std::array sine_table_400s_12bit = std::to_array<uint16_t>(
{
        2094    ,
        2110    ,
        2126    ,
        2142    ,
        2158    ,
        2174    ,
        2190    ,
        2206    ,
        2222    ,
        2238    ,
        2254    ,
        2270    ,
        2286    ,
        2301    ,
        2317    ,
        2333    ,
        2348    ,
        2364    ,
        2379    ,
        2394    ,
        2410    ,
        2425    ,
        2440    ,
        2455    ,
        2470    ,
        2485    ,
        2499    ,
        2514    ,
        2528    ,
        2543    ,
        2557    ,
        2571    ,
        2585    ,
        2599    ,
        2613    ,
        2627    ,
        2640    ,
        2654    ,
        2667    ,
        2680    ,
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

});
//static inline constexpr uint16_t sine_table_200samples_12bit[]=

static inline constexpr std::array sine_table_200samples_12bit = std::to_array<uint16_t>(
{
        2110    ,
        2142    ,
        2174    ,
        2206    ,
        2238    ,
        2270    ,
        2301    ,
        2333    ,
        2364    ,
        2394    ,
        2425    ,
        2455    ,
        2485    ,
        2514    ,
        2543    ,
        2571    ,
        2599    ,
        2627    ,
        2654    ,
        2680    ,
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
    2122    ,
    2124    ,
    2126    ,
    2128    ,
    2130    ,
    2132    ,
    2134    ,
    2136    ,
    2138    ,
    2140    ,
    2142    ,
    2144    ,
    2146    ,
    2147    ,
    2149    ,
    2151    ,
    2153    ,
    2155    ,
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

});

#endif /* INC_SINE_HPP_ */
