ironiron/LCRmeter/LCRmeter_CODE/Inc/sine.hpp

/*
 * sine.hpp
 *
 *  Created on: 18.05.2019
 *      Author: Rafał
 */

#ifndef SINE_HPP_
#define SINE_HPP_

//#include <array>

#if 0

static const uint16_t sine_table[]=
{
  128,131,134,137,140,143,146,149,
  152,156,159,162,165,168,171,174,
  176,179,182,185,188,191,193,196,
  199,201,204,206,209,211,213,216,
  218,220,222,224,226,228,230,232,
  234,235,237,239,240,242,243,244,
  246,247,248,249,250,251,251,252,
  253,253,254,254,254,255,255,255,
  255,255,255,255,254,254,253,253,
  252,252,251,250,249,248,247,246,
  245,244,242,241,239,238,236,235,
  233,231,229,227,225,223,221,219,
  217,215,212,210,207,205,202,200,
  197,195,192,189,186,184,181,178,
  175,172,169,166,163,160,157,154,
  151,148,145,142,138,135,132,129,
  126,123,120,117,113,110,107,104,
  101,98,95,92,89,86,83,80,
  77,74,71,69,66,63,60,58,
  55,53,50,48,45,43,40,38,
  36,34,32,30,28,26,24,22,
  20,19,17,16,14,13,11,10,
  9,8,7,6,5,4,3,3,
  2,2,1,1,0,0,0,0,
  0,0,0,1,1,1,2,2,
  3,4,4,5,6,7,8,9,
  11,12,13,15,16,18,20,21,
  23,25,27,29,31,33,35,37,
  39,42,44,46,49,51,54,56,
  59,62,64,67,70,73,76,79,
  81,84,87,90,93,96,99,103,
  106,109,112,115,118,121,124
};

#else
static const uint8_t sine_table[]=
{
    0	,	0	,	131	,
    0	,	0	,	135	,
    0	,	0	,	139	,
    0	,	0	,	143	,
    0	,	0	,	147	,
    0	,	0	,	151	,
    0	,	0	,	154	,
    0	,	0	,	158	,
    0	,	0	,	161	,
    0	,	0	,	165	,
    0	,	0	,	168	,
    0	,	0	,	171	,
    0	,	0	,	174	,
    0	,	0	,	176	,
    0	,	0	,	179	,
    0	,	0	,	181	,
    0	,	0	,	183	,
    0	,	0	,	185	,
    0	,	0	,	187	,
    0	,	0	,	188	,
    0	,	0	,	189	,
    0	,	0	,	190	,
    0	,	0	,	190	,
    0	,	0	,	191	,
    0	,	0	,	191	,
    0	,	0	,	191	,
    0	,	0	,	190	,
    0	,	0	,	190	,
    0	,	0	,	189	,
    0	,	0	,	188	,
    0	,	0	,	187	,
    0	,	0	,	185	,
    0	,	0	,	183	,
    0	,	0	,	181	,
    0	,	0	,	179	,
    0	,	0	,	176	,
    0	,	0	,	174	,
    0	,	0	,	171	,
    0	,	0	,	168	,
    0	,	0	,	165	,
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
};

#endif

static constexpr uint32_t sine_table_lenght=(sizeof(sine_table)/sizeof(*sine_table));





#endif /* SINE_HPP_ */
