ironiron/LCRmeter/LCRmeter_CODE/Core/Inc/version.h

/*
 * version.h
 *
 *  Created on: 29 pa?? 2023
 *      Author: Rafa??
 */

#ifndef INC_VERSION_H_
#define INC_VERSION_H_


#define VERSION_MAJOR 2
#define VERSION_MINOR 1
#define VERSION_PATCH 0
#define VERSION_BUILD 621

#define VERSION_STRINGIFY(a) #a


#endif /* INC_VERSION_H_ */
