ironiron/LCRmeter/LCRmeter_CODE/tests/Waveformarythmetics_test.cpp

/**
 ******************************************************************************
 * @file    Waveformarythmetics_test.cpp
 * @author  Rafał Mazurkiewicz
 * @date    09.10.2019
 * @brief   Signal conditioning for LCRmeter's ADC purposes
 ******************************************************************************
 * @attention
 * &copy; standard MIT License COPYRIGHT(c) 2019 Rafał Mazurkiewicz
 ******************************************************************************
 */

#include <Waveformarythmetics.hpp>

#include <catch.hpp>
#include <testing.hpp>
#include <stdint.h>
#include "real_data.hpp"

TEST_CASE( "calculating moving mean")
{

  uint32_t buf[10]={10 | (3<<16),
		      5 | (5<<16),
		      2 | (2<<16),
		      1 | (3<<16),
		      3 | (3<<16),
		      4 | (3<<16),
		      2 | (4<<16),
		      2 | (9<<16),
		      2 | (5<<16),
		      1 | (3<<16)};

  Waveform_arythmetics::Calc_Moving_Average(buf,10,3);

  REQUIRE(Waveform_arythmetics::filtered_buffer[0][0]==5);
  REQUIRE(Waveform_arythmetics::filtered_buffer[0][1]==2);
  REQUIRE(Waveform_arythmetics::filtered_buffer[0][2]==2);
  REQUIRE(Waveform_arythmetics::filtered_buffer[0][3]==0);

  REQUIRE(Waveform_arythmetics::filtered_buffer[1][0]==3);
  REQUIRE(Waveform_arythmetics::filtered_buffer[1][1]==3);
  REQUIRE(Waveform_arythmetics::filtered_buffer[1][2]==6);
  REQUIRE(Waveform_arythmetics::filtered_buffer[1][3]==0);

  REQUIRE(Waveform_arythmetics::buffer_size==3);

  Waveform_arythmetics::Calc_Moving_Average(buf,10,1);

  REQUIRE(Waveform_arythmetics::filtered_buffer[0][0]==10);
  REQUIRE(Waveform_arythmetics::filtered_buffer[0][1]==5);
  REQUIRE(Waveform_arythmetics::filtered_buffer[0][2]==2);
  REQUIRE(Waveform_arythmetics::filtered_buffer[0][3]==1);
  REQUIRE(Waveform_arythmetics::filtered_buffer[0][4]==3);
  REQUIRE(Waveform_arythmetics::filtered_buffer[0][5]==4);
  REQUIRE(Waveform_arythmetics::filtered_buffer[0][6]==2);
  REQUIRE(Waveform_arythmetics::filtered_buffer[0][7]==2);
  REQUIRE(Waveform_arythmetics::filtered_buffer[0][8]==2);
  REQUIRE(Waveform_arythmetics::filtered_buffer[0][9]==1);

  REQUIRE(Waveform_arythmetics::buffer_size==10);

  Waveform_arythmetics::Calc_Moving_Average(buf,10,2);

  REQUIRE(Waveform_arythmetics::filtered_buffer[0][0]==7);
  REQUIRE(Waveform_arythmetics::filtered_buffer[0][1]==1);
  REQUIRE(Waveform_arythmetics::filtered_buffer[0][2]==3);
  REQUIRE(Waveform_arythmetics::filtered_buffer[0][3]==2);
  REQUIRE(Waveform_arythmetics::filtered_buffer[0][4]==1);

  REQUIRE(Waveform_arythmetics::buffer_size==5);
}

TEST_CASE( "Finds peaks")
{

  Waveform_arythmetics::buffer_size=10;
  Waveform_arythmetics::mid_voltage[0]=5;
  Waveform_arythmetics::mid_voltage[1]=5;
  Waveform_arythmetics::hysteresis_samples=1;

  Waveform_arythmetics::filtered_buffer[0][0]=6;
  Waveform_arythmetics::filtered_buffer[0][1]=7;
  Waveform_arythmetics::filtered_buffer[0][2]=8;//
  Waveform_arythmetics::filtered_buffer[0][3]=2;
  Waveform_arythmetics::filtered_buffer[0][4]=4;
  Waveform_arythmetics::filtered_buffer[0][5]=5;
  Waveform_arythmetics::filtered_buffer[0][6]=2;
  Waveform_arythmetics::filtered_buffer[0][7]=1;
  Waveform_arythmetics::filtered_buffer[0][8]=0;
  Waveform_arythmetics::filtered_buffer[0][9]=1;

  Waveform_arythmetics::filtered_buffer[1][0]=0;
  Waveform_arythmetics::filtered_buffer[1][1]=2;
  Waveform_arythmetics::filtered_buffer[1][2]=3;
  Waveform_arythmetics::filtered_buffer[1][3]=6;
  Waveform_arythmetics::filtered_buffer[1][4]=7;
  Waveform_arythmetics::filtered_buffer[1][5]=9;//
  Waveform_arythmetics::filtered_buffer[1][6]=2;
  Waveform_arythmetics::filtered_buffer[1][7]=1;
  Waveform_arythmetics::filtered_buffer[1][8]=0;
  Waveform_arythmetics::filtered_buffer[1][9]=1;

  Waveform_arythmetics::Find_Peaks();

  REQUIRE(Waveform_arythmetics::nbr_of_peaks[0]==1);
  REQUIRE(Waveform_arythmetics::nbr_of_peaks[1]==1);

  REQUIRE(Waveform_arythmetics::peaks[0][0]==2);
  REQUIRE(Waveform_arythmetics::peaks[1][0]==5);

}

TEST_CASE( "Finds more than one peak")
{

  Waveform_arythmetics::buffer_size=10;
  Waveform_arythmetics::point_time=10;//microseconds
  Waveform_arythmetics::mid_voltage[0]=5;
  Waveform_arythmetics::mid_voltage[1]=5;
  Waveform_arythmetics::hysteresis_samples=1;

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
  Waveform_arythmetics::filtered_buffer[1][5]=7;
  Waveform_arythmetics::filtered_buffer[1][6]=10;//
  Waveform_arythmetics::filtered_buffer[1][7]=1;
  Waveform_arythmetics::filtered_buffer[1][8]=2;
  Waveform_arythmetics::filtered_buffer[1][9]=0;

  Waveform_arythmetics::Find_Peaks();


  REQUIRE(Waveform_arythmetics::nbr_of_peaks[0]==2);
  REQUIRE(Waveform_arythmetics::nbr_of_peaks[1]==2);
  REQUIRE(Waveform_arythmetics::peaks[0][0]==2);
  REQUIRE(Waveform_arythmetics::peaks[0][1]==7);
  REQUIRE(Waveform_arythmetics::peaks[1][0]==2);
  REQUIRE(Waveform_arythmetics::peaks[1][1]==6);

}

TEST_CASE( "Finds one peak and ignore boundary peaks")
{

  Waveform_arythmetics::buffer_size=10;
  Waveform_arythmetics::user_point_time=10;//microseconds
  Waveform_arythmetics::mid_voltage[0]=5;
  Waveform_arythmetics::hysteresis_samples=1;


  Waveform_arythmetics::filtered_buffer[0][0]=13;//Ignore first 4 even though hysteresis = 2
  Waveform_arythmetics::filtered_buffer[0][1]=12;
  Waveform_arythmetics::filtered_buffer[0][2]=11;
  Waveform_arythmetics::filtered_buffer[0][3]=11;
  Waveform_arythmetics::filtered_buffer[0][4]=3;
  Waveform_arythmetics::filtered_buffer[0][5]=3;
  Waveform_arythmetics::filtered_buffer[0][6]=6;
  Waveform_arythmetics::filtered_buffer[0][7]=8;//OK
  Waveform_arythmetics::filtered_buffer[0][8]=4;
  Waveform_arythmetics::filtered_buffer[0][9]=0;

  Waveform_arythmetics::filtered_buffer[1][0]=0;
  Waveform_arythmetics::filtered_buffer[1][1]=6;
  Waveform_arythmetics::filtered_buffer[1][2]=6;
  Waveform_arythmetics::filtered_buffer[1][3]=10;//ok
  Waveform_arythmetics::filtered_buffer[1][4]=4;
  Waveform_arythmetics::filtered_buffer[1][5]=2;
  Waveform_arythmetics::filtered_buffer[1][6]=10;//ignore the rest 4
  Waveform_arythmetics::filtered_buffer[1][7]=11;
  Waveform_arythmetics::filtered_buffer[1][8]=12;
  Waveform_arythmetics::filtered_buffer[1][9]=13;
  Waveform_arythmetics::Find_Peaks();

  REQUIRE(Waveform_arythmetics::nbr_of_peaks[0]==1);
  REQUIRE(Waveform_arythmetics::nbr_of_peaks[1]==1);
  REQUIRE(Waveform_arythmetics::peaks[0][0]==7);
  REQUIRE(Waveform_arythmetics::peaks[1][0]==3);
}

#include <iostream>

TEST_CASE( "Finds one minimum and ignore boundary peaks")
{

  Waveform_arythmetics::buffer_size=10;
  Waveform_arythmetics::user_point_time=10;//microseconds
  Waveform_arythmetics::mid_voltage[0]=5;
  Waveform_arythmetics::hysteresis_samples=1;


  Waveform_arythmetics::filtered_buffer[0][0]=0;//Ignore first 4 even though hysteresis = 2
  Waveform_arythmetics::filtered_buffer[0][1]=0;
  Waveform_arythmetics::filtered_buffer[0][2]=1;
  Waveform_arythmetics::filtered_buffer[0][3]=1;
  Waveform_arythmetics::filtered_buffer[0][4]=10;
  Waveform_arythmetics::filtered_buffer[0][5]=10;
  Waveform_arythmetics::filtered_buffer[0][6]=4;
  Waveform_arythmetics::filtered_buffer[0][7]=3;//OK
  Waveform_arythmetics::filtered_buffer[0][8]=4;
  Waveform_arythmetics::filtered_buffer[0][9]=10;

  Waveform_arythmetics::Find_Peaks();

  REQUIRE(Waveform_arythmetics::nbr_of_minimas[0]==1);
  REQUIRE(Waveform_arythmetics::minimas[0][0]==7);
}

TEST_CASE( "Finds one minimum")
{

  Waveform_arythmetics::buffer_size=10;
  Waveform_arythmetics::user_point_time=10;//microseconds
  Waveform_arythmetics::mid_voltage[0]=5;
  Waveform_arythmetics::mid_voltage[1]=5;
  Waveform_arythmetics::hysteresis_samples=1;


  Waveform_arythmetics::filtered_buffer[0][0]=6;
  Waveform_arythmetics::filtered_buffer[0][1]=6;
  Waveform_arythmetics::filtered_buffer[0][2]=11;
  Waveform_arythmetics::filtered_buffer[0][3]=11;
  Waveform_arythmetics::filtered_buffer[0][4]=4;
  Waveform_arythmetics::filtered_buffer[0][5]=3;
  Waveform_arythmetics::filtered_buffer[0][6]=2;//ok
  Waveform_arythmetics::filtered_buffer[0][7]=8;
  Waveform_arythmetics::filtered_buffer[0][8]=9;
  Waveform_arythmetics::filtered_buffer[0][9]=10;

  Waveform_arythmetics::filtered_buffer[1][0]=8;
  Waveform_arythmetics::filtered_buffer[1][1]=6;
  Waveform_arythmetics::filtered_buffer[1][2]=6;
  Waveform_arythmetics::filtered_buffer[1][3]=6;
  Waveform_arythmetics::filtered_buffer[1][4]=1;
  Waveform_arythmetics::filtered_buffer[1][5]=2;//ok
  Waveform_arythmetics::filtered_buffer[1][6]=3;
  Waveform_arythmetics::filtered_buffer[1][7]=4;
  Waveform_arythmetics::filtered_buffer[1][8]=7;
  Waveform_arythmetics::filtered_buffer[1][9]=6;

  Waveform_arythmetics::Find_Peaks();

  REQUIRE(Waveform_arythmetics::nbr_of_minimas[0]==1);
  REQUIRE(Waveform_arythmetics::nbr_of_minimas[1]==1);
  REQUIRE(Waveform_arythmetics::minimas[0][0]==6);
  REQUIRE(Waveform_arythmetics::minimas[1][0]==5);
}

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
  Waveform_arythmetics::filtered_buffer[0][32+4]=9;
  Waveform_arythmetics::filtered_buffer[0][32+5]=9;
  Waveform_arythmetics::filtered_buffer[0][32+6]=2;
  Waveform_arythmetics::filtered_buffer[0][32+7]=2;//here
  Waveform_arythmetics::filtered_buffer[0][40+0]=9;
  Waveform_arythmetics::filtered_buffer[0][40+1]=9;
  Waveform_arythmetics::filtered_buffer[0][40+2]=0;
  Waveform_arythmetics::filtered_buffer[0][40+3]=0;//here
  Waveform_arythmetics::filtered_buffer[0][40+4]=9;
  Waveform_arythmetics::filtered_buffer[0][40+5]=9;
  Waveform_arythmetics::filtered_buffer[0][40+6]=2;
  Waveform_arythmetics::filtered_buffer[0][40+7]=2;//here


  Waveform_arythmetics::Find_Peaks();

  REQUIRE(Waveform_arythmetics::nbr_of_minimas[0]==10);
  REQUIRE(Waveform_arythmetics::minimas[0][0]==3);
  REQUIRE(Waveform_arythmetics::minimas[0][1]==7);
  REQUIRE(Waveform_arythmetics::minimas[0][2]==8+3);
  REQUIRE(Waveform_arythmetics::minimas[0][3]==8+7);
  REQUIRE(Waveform_arythmetics::minimas[0][4]==16+3);
  REQUIRE(Waveform_arythmetics::minimas[0][5]==16+7);
  REQUIRE(Waveform_arythmetics::minimas[0][6]==24+3);
  REQUIRE(Waveform_arythmetics::minimas[0][7]==24+7);
  REQUIRE(Waveform_arythmetics::minimas[0][8]==32+3);
  REQUIRE(Waveform_arythmetics::minimas[0][9]==32+7);
}



TEST_CASE( "Find center of peak and minimas")
{

  Waveform_arythmetics::buffer_size=10;
  Waveform_arythmetics::user_point_time=10;//microseconds
  Waveform_arythmetics::mid_voltage[0]=5;
  Waveform_arythmetics::mid_voltage[1]=5;
  Waveform_arythmetics::hysteresis_samples=1;

  Waveform_arythmetics::filtered_buffer[0][0]=7;
  Waveform_arythmetics::filtered_buffer[0][1]=7;
  Waveform_arythmetics::filtered_buffer[0][2]=8;
  Waveform_arythmetics::filtered_buffer[0][3]=8;//
  Waveform_arythmetics::filtered_buffer[0][4]=8;
  Waveform_arythmetics::filtered_buffer[0][5]=4;
  Waveform_arythmetics::filtered_buffer[0][6]=2;
  Waveform_arythmetics::filtered_buffer[0][7]=2;
  Waveform_arythmetics::filtered_buffer[0][8]=2;
  Waveform_arythmetics::filtered_buffer[0][9]=2;

  Waveform_arythmetics::filtered_buffer[1][0]=4;
  Waveform_arythmetics::filtered_buffer[1][1]=4;
  Waveform_arythmetics::filtered_buffer[1][2]=3;
  Waveform_arythmetics::filtered_buffer[1][3]=3;
  Waveform_arythmetics::filtered_buffer[1][4]=1;
  Waveform_arythmetics::filtered_buffer[1][5]=1;//
  Waveform_arythmetics::filtered_buffer[1][6]=1;
  Waveform_arythmetics::filtered_buffer[1][7]=1;
  Waveform_arythmetics::filtered_buffer[1][8]=12;
  Waveform_arythmetics::filtered_buffer[1][9]=20;

  Waveform_arythmetics::Find_Peaks();
//TODO this is strange!!!!!!!!!!!!!!!! why minimas is OK even though I haven't coded that yet!!
  REQUIRE(Waveform_arythmetics::nbr_of_peaks[0]==1);
  REQUIRE(Waveform_arythmetics::nbr_of_minimas[1]==1);
  REQUIRE(Waveform_arythmetics::peaks[0][0]==3);
  REQUIRE(Waveform_arythmetics::minimas[1][0]==5);
}

TEST_CASE( "Find center of peak that is close to boundary condition")
{

  Waveform_arythmetics::buffer_size=10;
  Waveform_arythmetics::user_point_time=10;//microseconds
  Waveform_arythmetics::mid_voltage[0]=5;
  Waveform_arythmetics::mid_voltage[1]=5;
  Waveform_arythmetics::hysteresis_samples=3;

  Waveform_arythmetics::filtered_buffer[0][0]=7;
  Waveform_arythmetics::filtered_buffer[0][1]=7;
  Waveform_arythmetics::filtered_buffer[0][2]=7;
  Waveform_arythmetics::filtered_buffer[0][3]=7;
  Waveform_arythmetics::filtered_buffer[0][4]=7;
  Waveform_arythmetics::filtered_buffer[0][5]=11;
  Waveform_arythmetics::filtered_buffer[0][6]=11;//
  Waveform_arythmetics::filtered_buffer[0][7]=11;
  Waveform_arythmetics::filtered_buffer[0][8]=10;
  Waveform_arythmetics::filtered_buffer[0][9]=8;

  Waveform_arythmetics::Find_Peaks();

  REQUIRE(Waveform_arythmetics::nbr_of_peaks[0]==1);
  REQUIRE(Waveform_arythmetics::peaks[0][0]==6);
}

TEST_CASE( "Find center of minimum that is close to boundary condition")
{

  Waveform_arythmetics::buffer_size=10;
  Waveform_arythmetics::user_point_time=10;//microseconds
  Waveform_arythmetics::mid_voltage[0]=5;
  Waveform_arythmetics::mid_voltage[1]=5;
  Waveform_arythmetics::hysteresis_samples=3;

  Waveform_arythmetics::filtered_buffer[0][0]=4;
  Waveform_arythmetics::filtered_buffer[0][1]=3;
  Waveform_arythmetics::filtered_buffer[0][2]=3;
  Waveform_arythmetics::filtered_buffer[0][3]=2;
  Waveform_arythmetics::filtered_buffer[0][4]=2;
  Waveform_arythmetics::filtered_buffer[0][5]=0;
  Waveform_arythmetics::filtered_buffer[0][6]=0;//
  Waveform_arythmetics::filtered_buffer[0][7]=0;
  Waveform_arythmetics::filtered_buffer[0][8]=1;
  Waveform_arythmetics::filtered_buffer[0][9]=2;

  Waveform_arythmetics::Find_Peaks();

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
  Waveform_arythmetics::filtered_buffer[1][5]=1;//here
  Waveform_arythmetics::filtered_buffer[1][6]=2;
  Waveform_arythmetics::filtered_buffer[1][7]=1;
  Waveform_arythmetics::filtered_buffer[1][8]=10;
  Waveform_arythmetics::filtered_buffer[1][9]=10;

  Waveform_arythmetics::Find_Peaks();

  REQUIRE(Waveform_arythmetics::nbr_of_minimas[0]==1);
  REQUIRE(Waveform_arythmetics::nbr_of_minimas[1]==1);
  REQUIRE(Waveform_arythmetics::minimas[0][0]==4);
  REQUIRE(Waveform_arythmetics::minimas[1][0]==5);
}

TEST_CASE( "Find peak based on real data.")
{

  Waveform_arythmetics::buffer_size=real_data_length;
  Waveform_arythmetics::user_point_time=10;//microseconds
  Waveform_arythmetics::mid_voltage[0]=2000;
  Waveform_arythmetics::mid_voltage[1]=2000;
  Waveform_arythmetics::hysteresis_samples=10;

  for (unsigned int j = 0; j < 2; j++)
    {
        for (unsigned int i = 0; i < real_data_length; i++)
        {
            Waveform_arythmetics::filtered_buffer[j][i] = real_data[i][j];
        }
    }

  Waveform_arythmetics::Find_Peaks();

  REQUIRE(Waveform_arythmetics::nbr_of_peaks[0]>0);
  REQUIRE(Waveform_arythmetics::peaks[0][0]>=126);
  REQUIRE(Waveform_arythmetics::peaks[0][0]<=129);
}

TEST_CASE( "Find peaks and minimas based on real data.")
{

  Waveform_arythmetics::buffer_size=real_data_length;
  Waveform_arythmetics::user_point_time=10;//microseconds
  Waveform_arythmetics::mid_voltage[0]=2000;
  Waveform_arythmetics::mid_voltage[1]=2000;
  Waveform_arythmetics::hysteresis_samples=10;

  for (unsigned int j = 0; j < 2; j++)
    {
        for (unsigned int i = 0; i < real_data_length; i++)
        {
            Waveform_arythmetics::filtered_buffer[j][i] = real_data[i][j];
        }
    }

  Waveform_arythmetics::Find_Peaks();

  REQUIRE(Waveform_arythmetics::nbr_of_peaks[0]==2);
  REQUIRE(Waveform_arythmetics::nbr_of_minimas[0]==2);
  REQUIRE(Waveform_arythmetics::peaks[0][0]==126);
  REQUIRE(Waveform_arythmetics::peaks[0][1]==303);
  REQUIRE(Waveform_arythmetics::minimas[0][0]==35);
  REQUIRE(Waveform_arythmetics::minimas[0][1]==214);
}

TEST_CASE( "Gets frequency")
{
  Waveform_arythmetics::buffer_size=10;
  Waveform_arythmetics::point_time=10;//microseconds

  Waveform_arythmetics::nbr_of_peaks[0]=2;
  Waveform_arythmetics::peaks[0][0]=2;
  Waveform_arythmetics::peaks[0][1]=7;

  Waveform_arythmetics::Calc_Frequency();

  REQUIRE(Waveform_arythmetics::frequency==20000);

}


TEST_CASE( "Gets frequency from minimas")
{
  Waveform_arythmetics::buffer_size=10;
  Waveform_arythmetics::point_time=10;//microseconds

  Waveform_arythmetics::nbr_of_peaks[0]=0;
  Waveform_arythmetics::nbr_of_minimas[0]=2;
  Waveform_arythmetics::peaks[0][0]=0;
  Waveform_arythmetics::peaks[0][1]=0;
  Waveform_arythmetics::minimas[0][0]=2;
  Waveform_arythmetics::minimas[0][1]=7;

  Waveform_arythmetics::Calc_Frequency();

  REQUIRE(Waveform_arythmetics::frequency==20000);

}

TEST_CASE( "Gets frequency from one peak and one minimum")
{
  Waveform_arythmetics::buffer_size=10;
  Waveform_arythmetics::point_time=10;//microseconds

  Waveform_arythmetics::nbr_of_peaks[0]=1;
  Waveform_arythmetics::nbr_of_minimas[0]=1;
  Waveform_arythmetics::peaks[0][0]=2;
  Waveform_arythmetics::peaks[0][1]=0;
  Waveform_arythmetics::minimas[0][0]=7;
  Waveform_arythmetics::minimas[0][1]=0;

  Waveform_arythmetics::Calc_Frequency();

  REQUIRE(Waveform_arythmetics::frequency==10000);

}

TEST_CASE( "gets 0 frequency if cannot detect")
{
  Waveform_arythmetics::buffer_size=10;
  Waveform_arythmetics::point_time=10;//microseconds

  Waveform_arythmetics::nbr_of_peaks[0]=1;
  Waveform_arythmetics::nbr_of_minimas[0]=0;
  Waveform_arythmetics::peaks[0][0]=2;
  Waveform_arythmetics::peaks[0][1]=0;
  Waveform_arythmetics::minimas[0][0]=7;
  Waveform_arythmetics::minimas[0][1]=0;

  Waveform_arythmetics::Calc_Frequency();

  REQUIRE(Waveform_arythmetics::frequency==0);

}

TEST_CASE( "Calculate phase swift")
{
  Waveform_arythmetics::frequency=10000;
  Waveform_arythmetics::point_time=10;

  Waveform_arythmetics::nbr_of_peaks[0]=2;
  Waveform_arythmetics::nbr_of_peaks[1]=2;
  Waveform_arythmetics::nbr_of_minimas[0]=0;
  Waveform_arythmetics::nbr_of_minimas[1]=0;
  Waveform_arythmetics::peaks[0][0]=100;
  Waveform_arythmetics::peaks[1][0]=101;//Initial values: 10 points per full period(100us).
  Waveform_arythmetics::peaks[0][1]=110;
  Waveform_arythmetics::peaks[1][1]=0;

  Waveform_arythmetics::Calc_Alfa();

  //exactly 36 degs.
  REQUIRE(Waveform_arythmetics::alfa > 35.95);
  REQUIRE(Waveform_arythmetics::alfa < 36.05);

  Waveform_arythmetics::frequency=10000;
  Waveform_arythmetics::point_time=1;
  Waveform_arythmetics::peaks[0][0]=32;
  Waveform_arythmetics::peaks[1][0]=100;//Initial values: 100 points per full period(100us).
  Waveform_arythmetics::peaks[0][1]=132;

  Waveform_arythmetics::Calc_Alfa();

  //115.2
  REQUIRE(Waveform_arythmetics::alfa>-115.3);
  REQUIRE(Waveform_arythmetics::alfa<-115.1);
}

TEST_CASE( "Calculate phase swift and if 180 deg assumes negative sign")
{
  Waveform_arythmetics::frequency=10000;
  Waveform_arythmetics::point_time=10;

  Waveform_arythmetics::nbr_of_peaks[0]=2;
  Waveform_arythmetics::nbr_of_peaks[1]=2;
  Waveform_arythmetics::nbr_of_minimas[0]=0;
  Waveform_arythmetics::nbr_of_minimas[1]=0;
  Waveform_arythmetics::peaks[0][0]=100;
  Waveform_arythmetics::peaks[1][0]=105;//Initial values: 10 points per full period(100us).
  Waveform_arythmetics::peaks[0][1]=0;
  Waveform_arythmetics::peaks[1][1]=0;

  Waveform_arythmetics::Calc_Alfa();

  REQUIRE(Waveform_arythmetics::alfa <-179.99);
  REQUIRE(Waveform_arythmetics::alfa >-180.01);
}

TEST_CASE( "Calculate phase swift and decide sign (+/-)")
{
  Waveform_arythmetics::frequency=10000;
  Waveform_arythmetics::point_time=10;
  Waveform_arythmetics::mid_voltage[0]=5;
  Waveform_arythmetics::mid_voltage[1]=5;

  Waveform_arythmetics::nbr_of_peaks[0]=2;
  Waveform_arythmetics::nbr_of_peaks[1]=2;
  Waveform_arythmetics::peaks[0][0]=0;
  Waveform_arythmetics::peaks[1][0]=2;
  Waveform_arythmetics::peaks[0][1]=10;
  Waveform_arythmetics::peaks[1][1]=12;

  Waveform_arythmetics::Calc_Alfa();

  REQUIRE(Waveform_arythmetics::alfa >71.99);
  REQUIRE(Waveform_arythmetics::alfa <72.01);

  Waveform_arythmetics::peaks[0][0]=0;
  Waveform_arythmetics::peaks[1][0]=8;
  Waveform_arythmetics::peaks[0][1]=10;
  Waveform_arythmetics::peaks[1][1]=18;

  Waveform_arythmetics::Calc_Alfa();

  REQUIRE(Waveform_arythmetics::alfa <-71.99);
  REQUIRE(Waveform_arythmetics::alfa >-72.01);
}

TEST_CASE( "Calculate phase swift on the boundary conditions")
{
  Waveform_arythmetics::frequency=100000;
  Waveform_arythmetics::point_time=1;
  Waveform_arythmetics::mid_voltage[0]=5;
  Waveform_arythmetics::mid_voltage[1]=5;
  Waveform_arythmetics::nbr_of_peaks[0]=2;
  Waveform_arythmetics::nbr_of_peaks[1]=2;

  //Initial values: 10 points per full period(1us).
  Waveform_arythmetics::peaks[0][0]=10;
  Waveform_arythmetics::peaks[1][0]=14;
  Waveform_arythmetics::Calc_Alfa();
  REQUIRE(Waveform_arythmetics::alfa >143.99);
  REQUIRE(Waveform_arythmetics::alfa <144.01);

  Waveform_arythmetics::peaks[0][0]=10;
  Waveform_arythmetics::peaks[1][0]=11;
  Waveform_arythmetics::Calc_Alfa();
  REQUIRE(Waveform_arythmetics::alfa >35.99);
  REQUIRE(Waveform_arythmetics::alfa <36.01);

  Waveform_arythmetics::peaks[0][0]=10;
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
  Waveform_arythmetics::filtered_buffer[0][7]=0;
  Waveform_arythmetics::filtered_buffer[0][8]=10;
  Waveform_arythmetics::filtered_buffer[0][9]=10;

  uint32_t retval=0;
  retval=Waveform_arythmetics::Get_Edge_index(5,true);

  REQUIRE(retval==8);
}
