ironiron/LCRmeter/LCRmeter_CODE/tests/real_data.hpp

/*
 * real_data.hpp
 *
 *  Created on: 14 paź 2023
 *      Author: Rafał Mazurkiewicz
 *      MIT license
 */

#ifndef REAL_DATA_HPP_
#define REAL_DATA_HPP_

#include <stdint.h>

//real data aquired during testing
//original filename: raw2_avg3.csv
//first peak for chn1 should be detected between index 126-129
const uint16_t real_data_length = 333;
const uint16_t real_data[][real_data_length]=
{
        {   1664,1657   },
        {   1622,1594   },
        {   1581,1573   },
        {   1560,153    },
        {   1513,1499   },
        {   1513,1483   },
        {   1450,1441   },
        {   1434,142    },
        {   1403,1372   },
        {   1361,1352   },
        {   1340,131    },
        {   1310,1294   },
        {   1293,1262   },
        {   1246,1231   },
        {   1244,1215   },
        {   1200,1168   },
        {   1189,1167   },
        {   1168,1138   },
        {   1136,1121   },
        {   1122,109    },
        {   1100,1079   },
        {   1090,1059   },
        {   1058,1038   },
        {   1048,1027   },
        {   1027,996    },
        {   1017,997    },
        {   996,965 },
        {   986,96  },
        {   982,949 },
        {   965,939 },
        {   965,934 },
        {   949,923 },
        {   950,918 },
        {   949,917 },
        {   943,913 },
        {   933,902 },
        {   935,902 },
        {   934,901 },
        {   934,903 },
        {   934,902 },
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
};
#endif /* REAL_DATA_HPP_ */
