ironiron/LCRmeter/(commit log)

2019-03-10 added most of new components
    [lcrmeter.sch]
2019-03-10 schematic done
    [lcrmeter.sch]
2019-03-11 added voltage divider to oscilloscope
    [lcrmeter.sch]
2019-03-12 assigned footprints, fixed schematic, a little done PCB
    [lcrmeter.kicad_pcb, lcrmeter.sch]
2019-03-13 started routing added voltage divider for measuring supply foltage
    [lcrmeter.kicad_pcb, lcrmeter.sch]
2019-03-13 fixed resistors value, PCB done!
    [lcrmeter.kicad_pcb, lcrmeter.sch]
2019-03-14 deleted 1,5V diode protection, added op-amp for 1,5V(optional), added zones
    [lcrmeter.kicad_pcb, lcrmeter.sch]
2019-03-14 fix oscilloscope connection
    [lcrmeter.kicad_pcb, lcrmeter.sch]
2019-03-16 created CODE filesystem
    [lcrmeter-2019-02-28-13-48-41.sch, lcrmeter.kicad_pcb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]
2019-03-19 added docs and tests folders, created test configuration added Pwm class
2019-03-24 added Gerber and BOM files
    [lcrmeter.csv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]
2019-04-20 gitignore update, gerbers generated
    [lcrmeter-B.Cu.gbl, lcrmeter-B.Mask.gbs, lcrmeter-B.SilkS.gbo, lcrmeter-F.Cu.gtl, lcrmeter-F.Mask.gts, lcrmeter-F.SilkS.gto]
2019-04-20 added PWM class written tests added fakes update configuration
    [lcrmeter-B.Cu.gbl, lcrmeter-B.Mask.gbs, lcrmeter-B.SilkS.gbo, lcrmeter-F.Cu.gtl, lcrmeter-F.Mask.gts, lcrmeter-F.SilkS.gto, lcrmeter.drl]
2019-04-23 added neccesary files. addded PWM-hardware
2019-05-09 modified PWM class for use with many channels
2019-05-12 added brief documentation for part of software, and license
    [lcrmeter.kicad_pcb]
2019-05-12 added new i2c and dac classes
    [lcrmeter.sch]
2019-05-14 added DMA files, improved PWM compare func, I2C stars working a little
2019-05-15 i2c talks with ssd1306
2019-05-16 dma class- added new working func
2019-05-20 added tests for MCP47 driver- base functionality working. Resigned from DMA tests.
2019-06-20 fixed schematic- diode reference and minor problems
    [lcrmeter.kicad_pcb, lcrmeter.sch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]
2019-07-03 added some DMA functions; I2C big progress
2019-08-07 fix a little i2c added mcp47 library
    [DMA.hpp]
2019-08-22 I2C almost finished; fix DMA, added comments and delay library
    [DMA.hpp, Pwm.hpp, delay.c, delay.h, main.cpp, sine.hpp]
2019-08-26 OLED is displaying strings, flips, and mirrors
    [main.cpp]
2019-08-31 added some func. to oled; tried refractoring I2C. project not working
    [main.cpp]
2019-09-01 refractored i2c in unit tests; better testing namespaces
2019-10-02 splitted MCP47 into 2 separate device classes. Added ADC dual mode
2019-10-05 fix memory (de)allocation; added priority level to dma
    [DMA.hpp]
2019-10-07 Done DAC classes; fixed i2c's memory allocation; comments update
    [DMA.hpp, MCP47FEB.cpp, main.cpp, main.h, sine.hpp]
2019-10-09 swapping adc modes working
    [adc.cpp, adc.hpp]
2019-11-08 done LCRmath; fix comments
    [LCR calc.xlsx]
2019-11-13 swaped filteredbuffer; addded sampletime; clean a little
    [LCR calc.xlsx]
2019-11-20 testing buttons. added draft for fixing DAC
    [adc.cpp, main.cpp, main.h, sine.hpp]
2019-11-23 ADC improved. Osciloscope edge detection.
2019-11-23 added voltage&temperature adc
2019-11-24 added some func to Adc.
    [LCR calc.xlsx]
2020-02-01 fixed ADC
2020-02-08 final commit. NO future work scheduled. THE END xD
    [LCR calc.xlsx]
2023-02-25 updated readme, fixed few typos in docs, rearranged DAC and OLED directories
    [lcrmeter.sch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]
2023-03-08 SSD1306 final touches; MCP47 in 'safe' condition
    [lcrmeter.sch]
2023-03-08 fixed gitignore not ignoring files
    [DMA.hpp, LCRmath.cpp, LCRmath.hpp, LCRmath_test.cpp, LCRmeter.ioc, Pwm.hpp]
2023-03-14 refractored adc.c/h and deleted unused files
2023-03-20 minor fix in finding peaks of sine; removed printf from main.cpp
    [Waveformarythmetics.cpp, Waveformarythmetics.hpp, Waveformarythmetics_test.cpp, main.cpp]
2023-03-20 Migrated to CubeIDE and changed USB drivers to CDC class
2023-03-21 fixed unit_tests configuration and include headers
    [LCRmath.cpp, Waveformarythmetics.cpp]
2023-03-27 Initial USB development, currentlly not working
    [adc.hpp, main.cpp]
2023-04-01 added some printf for debugging
2023-04-01 added uart redirection and separet files for printf
2023-04-10 removed usb remnants from other branch; uart sending buffer
2023-07-01 added sending via uart data to external visualizer
2023-10-01 rewritten part of waweformarithmetics, but not working with real data
    [Snapshot1.csv, data.csv, raw.csv, raw2_avg3.csv, raw3_avg3.csv, wrong peak.csv]
2023-10-29 final fixes for waveform arithmetics, added automatic build number
    [raw2_avg3.xlsx]
2023-12-23 updated calculation; small fixes in calcus; playing with buttons
    [LCR calc.xlsx]
2023-12-23 started new design
    [lcrmeter.kicad_sch]
2023-12-26 some random schematic update
    [lcrmeter.kicad_sch]
2023-12-28 schematic done added generator for g4
    [lcrmeter.kicad_sch]
2023-12-29 placed components on PCB
    [lcrmeter.kicad_pcb, lcrmeter.kicad_sch]
2023-12-29 routing mostly done
    [lcrmeter.kicad_pcb, lcrmeter.kicad_sch]
2024-01-02 PCB done, needs review
    [lcrmeter.kicad_pcb]
2024-01-05 aesthetiques improvement; schematic generated, etc
    [lcrmeter.kicad_pcb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]
2024-01-28 generated code for the newer mcu
    [lcrmeter.csv]
2024-11-11 some playground for adc testing
2025-01-02 ADC in dual mode finally works; DAC output is now set to max possible frequncy for this HW; updated readmes
2025-01-05 Draft fix for not consistent amplitude measurment for sine; removed old I2C files; added automatic mid_voltage reference calculation
    [LCRmath.cpp, Waveformarythmetics.cpp, Waveformarythmetics.hpp, Waveformarythmetics_test.cpp, adc.cpp, adc.hpp, main.cpp, version.h]
2025-01-12 fixed calculations for capacitors, and inductors also (hopefully); fixed alpha calculation (now needs at least 2 peaks); added more sinewave samples
    [LCR calc.xlsx]
2025-01-19 refractored sine tables; DAC working in 12bit mode now; added excel with results history
    [LCR calc.xlsx, res.xlsx]
2025-02-09 added some notes on PCB
    [lcrmeter.kicad_sch]
2025-08-16 Update VREF measurment; refractor adc
2025-10-12 update cppcheck config; fix typos:
    [LCRmath.hpp, adc.cpp]
2025-11-13 code cleanup; usable oscilloscope mode; new 1khz LCR freg
    [LCR calc.xlsx]
2025-11-14 Fix math and results display; update readme
    [simulation.ods]
