ironiron/LCRmeter/(notices)

Notices in the files:
LCRmeter_CODE/Core/Src/main.cpp:
(C) COPYRIGHT STMicroelectronics *****END OF FILE
